VinceVol/High_Voltage_DC_Motor_Drive/Simulation/PMDC Motor.txt

* DC MOTOR MODEL SUBCURCUIT
* Pins: IN+ IN- SPEED POS
.SUBCKT DC_MOTOR 1 5 6 8
*V_AMP   1 0     AC 1  PWL(0MS 0V  1MS 10V  1000MS 10V  1010MS 0V  2000MS 0V)
*
* MOTOR VOLTAGE
RA	1	2	0.5
LA	2	3	0.0015
H_EMF	3 4	VSENSE2	0.05
VSENSE1	4	5	DC 0V
*
* MOTOR TORQUE BASED ON INERTIA AND FRICTION
H_TORQ	6 5	VSENSE1	0.05
LJ	6	7	0.00025
RB	7	8	0.0001
VSENSE2	8	0	DC	0V
*
* MOTOR POSITION
FPOS	5	11	VSENSE2	1
CPOS	11	5	1
RPOS	11	5	1MEG
.ENDS
