VinceVol/High_Voltage_DC_Motor_Drive/Readable_Schema/120VDC Treadmill Motor Controller/Order Sheet Amazon.csv

Reference | Qty | Value | Price | Exclude from BOM | Exclude from Board | Footprint | Datasheet
Cap Kit | 1 | https://www.amazon.com/Capacitor-Assortment-0-5pF-22uF-Electronics-Prototyping/dp/B0F38S1ZXJ |  |  |  | Capacitor_SMD:C_0603_1608Metric_Pad1.08x0.95mm_HandSolder | ~
Resistor Kit | 1 | https://www.amazon.com/Resistor-Assortment-Tolerance-Electronics-Prototyping/dp/B0F38XDMM5 |  |  |  | Resistor_SMD:R_0603_1608Metric_Pad0.98x0.95mm_HandSolder | ~
