VinceVol/High_Voltage_DC_Motor_Drive/Readable_Schema/Local_Components/ESMQ351VSN821MA45S/E-SNAP-IN_D35_L45__VSN_SLEEVE_STRUCTURE.stp

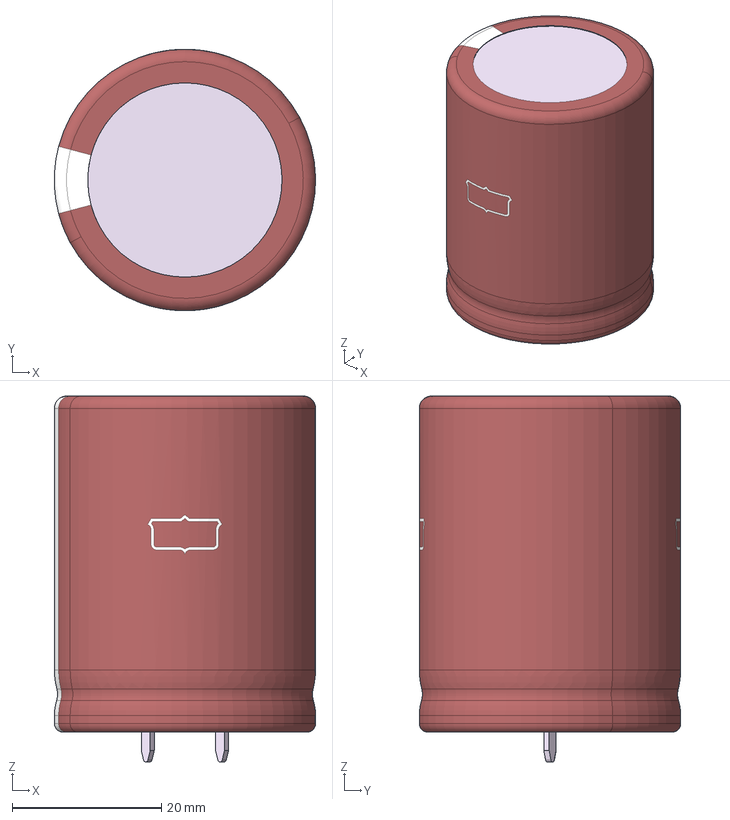
[picture p6: CAD file, 2026-10-08]
Readable_Schema/Local_Components/ESMQ351VSN821MA45S/E-SNAP-IN_D35_L45__VSN_SLEEVE_STRUCTURE.stp
35.0 x 35.0 x 49.0 mm
E-SNAP-IN_D35_L45_ELEMENT
E-SNAP-IN_VS_TERMINAL-
E-SNAP-IN_VS_TERMINAL+
