VinceVol/High_Voltage_DC_Motor_Drive/Readable_Schema/Local_Components/IRM-15-5/IRM-15-5--3DModel-STEP-56544.STEP

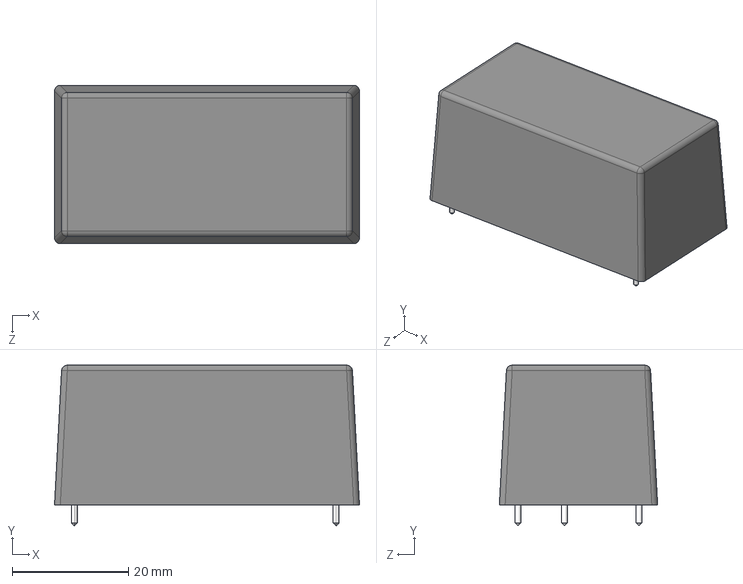
[picture p7: CAD file, 2026-10-08]
Readable_Schema/Local_Components/IRM-15-5/IRM-15-5--3DModel-STEP-56544.STEP
52.4 x 27.6 x 27.2 mm
