VinceVol/High_Voltage_DC_Motor_Drive/Readable_Schema/Local_Components/LGW2E102MELB40/CAP_B40_NCH.step

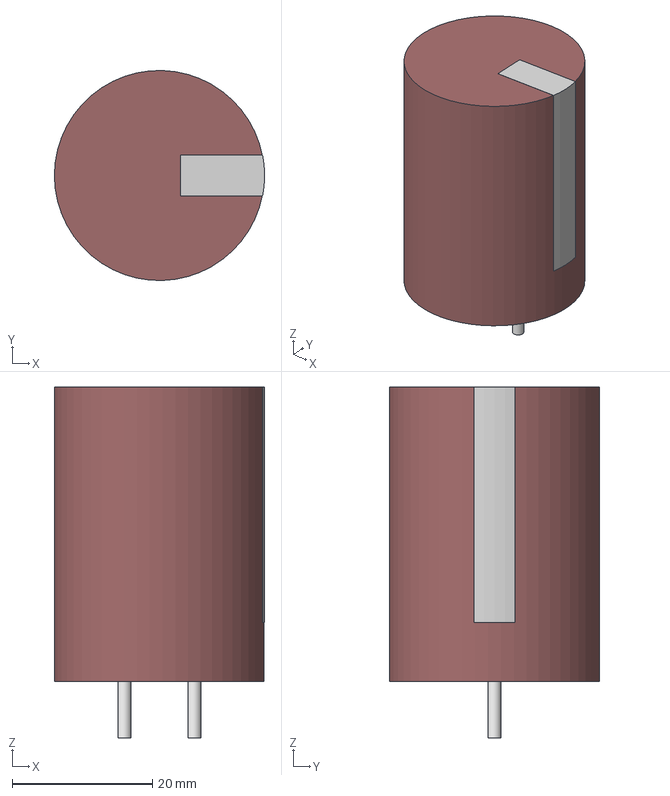
[picture p8: CAD file, 2026-10-08]
Readable_Schema/Local_Components/LGW2E102MELB40/CAP_B40_NCH.step
30.0 x 30.0 x 50.1 mm
