VinceVol/High_Voltage_DC_Motor_Drive/Readable_Schema/Local_Components/MSS1P4-M3_89A/MSS1P4-M3_89A.step

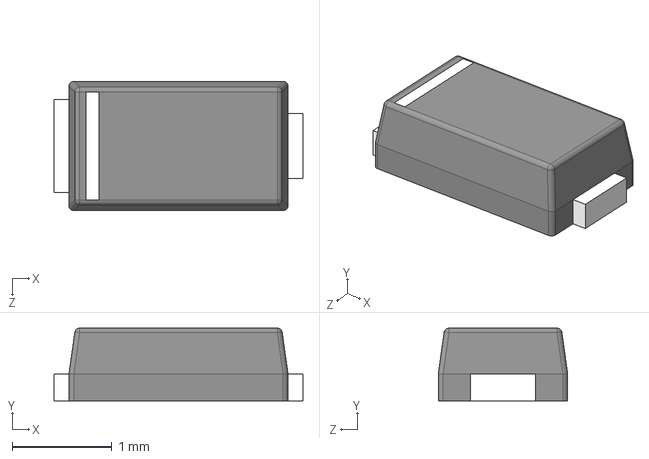
[picture p9: CAD file, 2026-10-08]
Readable_Schema/Local_Components/MSS1P4-M3_89A/MSS1P4-M3_89A.step
2.50 x 0.73 x 1.30 mm
