VinceVol/High_Voltage_DC_Motor_Drive/Readable_Schema/Local_Components/RCWCTE/RCWCTE.step

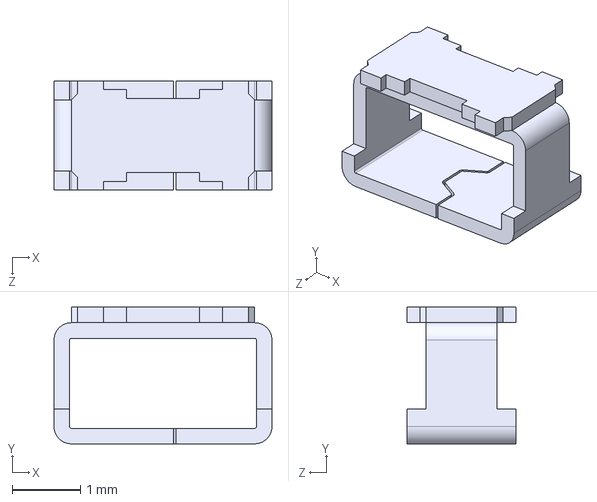
[picture p10: CAD file, 2026-02-23]
Readable_Schema/Local_Components/RCWCTE/RCWCTE.step
3.20 x 2.01 x 1.60 mm
