VinceVol/High_Voltage_DC_Motor_Drive/Readable_Schema/Local_Components/TB0011_350_03BE/TB0011-350-03BE.step

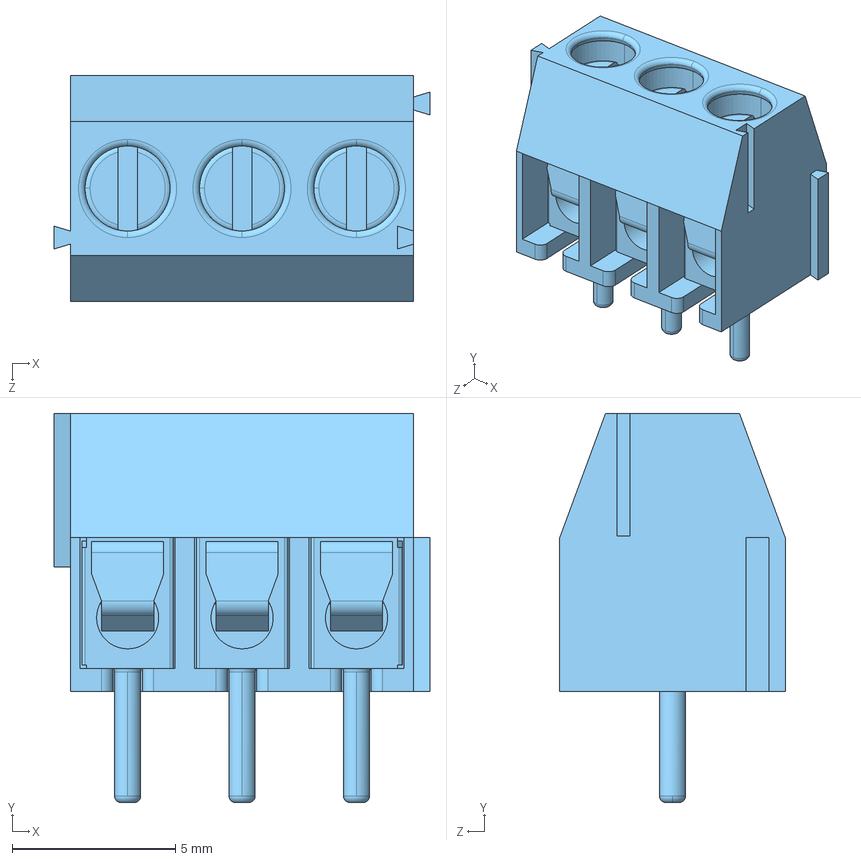
[picture p11: CAD file, 2026-02-23]
Readable_Schema/Local_Components/TB0011_350_03BE/TB0011-350-03BE.step
11.5 x 11.9 x 6.90 mm
