VinceVol/High_Voltage_DC_Motor_Drive/Readable_Schema/Local_Components/TB005_762_03BE/TB005 -762-03BE.step

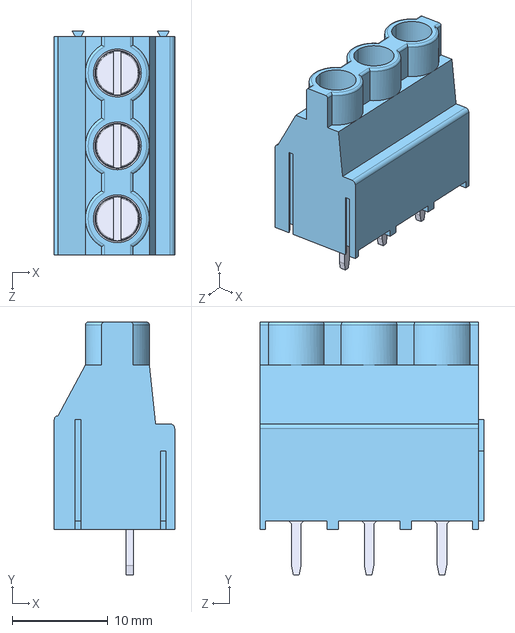
[picture p12: CAD file, 2026-02-19]
Readable_Schema/Local_Components/TB005_762_03BE/TB005 -762-03BE.step
12.6 x 26.5 x 23.5 mm
