VinceVol/High_Voltage_DC_Motor_Drive/Readable_Schema/Local_Components/TLV3201AIDBVR/TLV3201AIDBVR.step

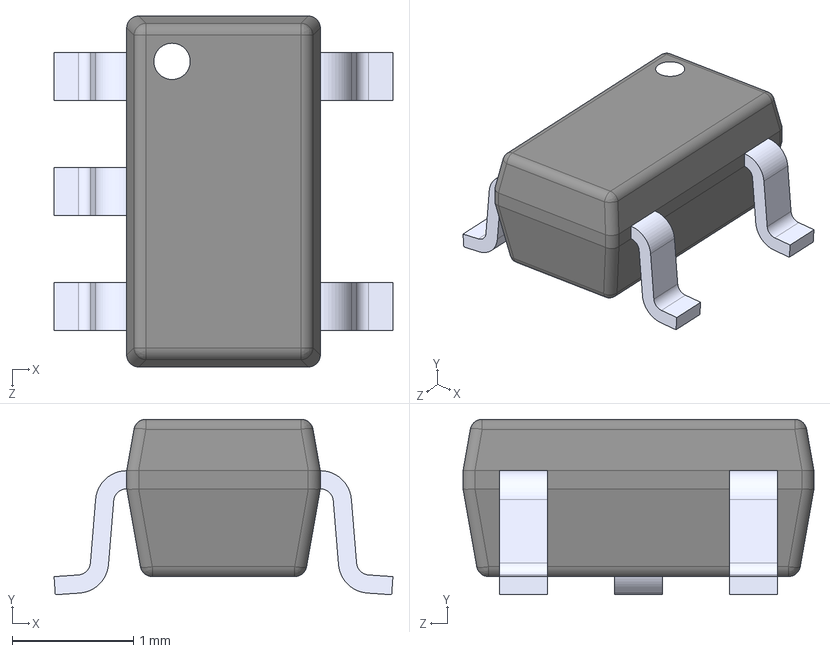
[picture p13: CAD file, 2026-10-08]
Readable_Schema/Local_Components/TLV3201AIDBVR/TLV3201AIDBVR.step
2.80 x 1.45 x 2.90 mm
