VinceVol/High_Voltage_DC_Motor_Drive/Cad/002_Test_Motor_Mount.FCStd

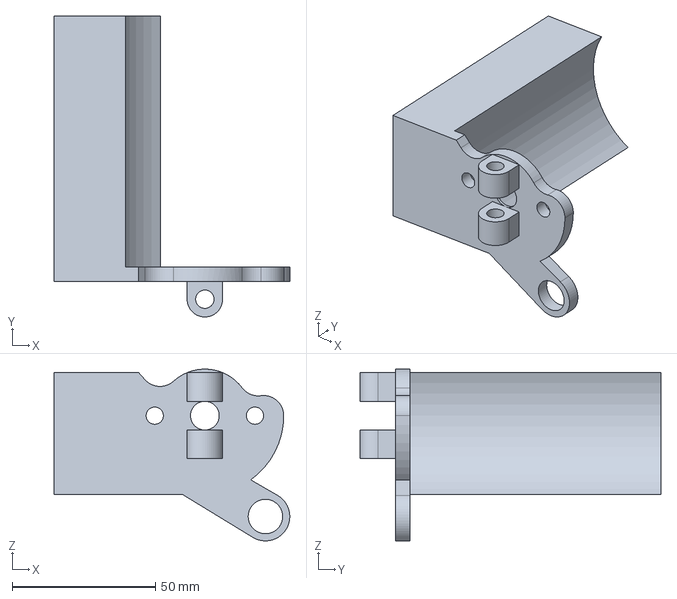
[picture p14: CAD file, 2026-11-10]
Cad/002_Test_Motor_Mount.FCStd
82.1 x 104.9 x 59.9 mm
