VinceVol/High_Voltage_DC_Motor_Drive/Cad/003_Magnet_MNT.FCStd

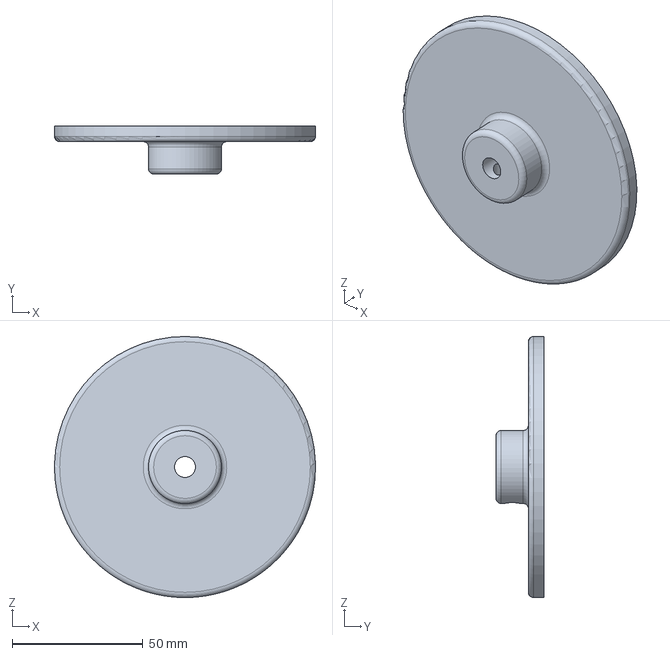
[picture p15: CAD file, 2026-11-09]
Cad/003_Magnet_MNT.FCStd
100.0 x 18.4 x 100.0 mm
