VinceVol/High_Voltage_DC_Motor_Drive/Cad/001_Test_Motor.FCStd

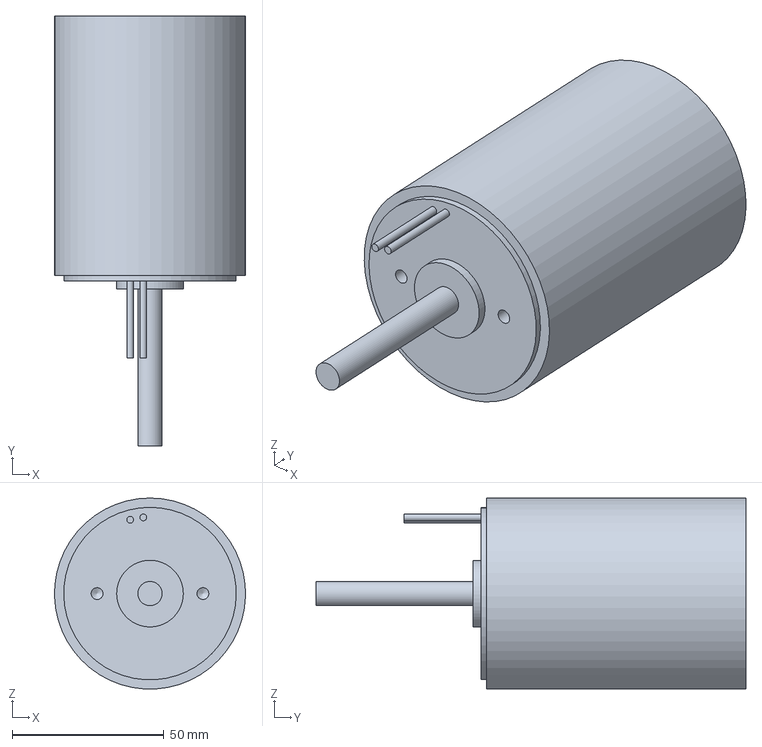
[picture p16: CAD file, 2026-11-09]
Cad/001_Test_Motor.FCStd
63.0 x 141.9 x 63.0 mm
