VinceVol/High_Voltage_DC_Motor_Drive/Cad/7674K93_DC Metallic-Object Proximity Switch016.FCStd

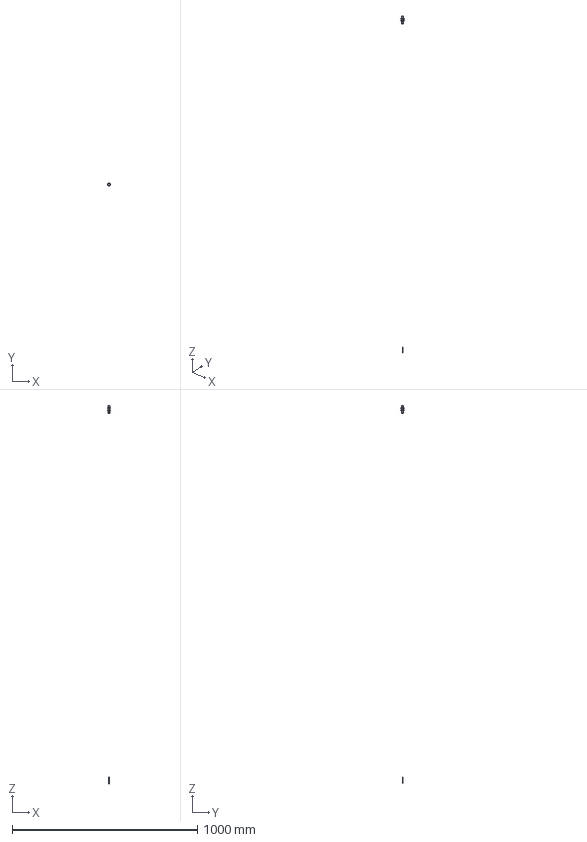
[picture p17: CAD file, 2026-11-09]
Cad/7674K93_DC Metallic-Object Proximity Switch016.FCStd
17.0 x 19.4 x 2043.2 mm
7674K93_DC Metallic-Object Proximity Switch
7674K93_DC Metallic-Object Proximity Switch001
7674K93_DC Metallic-Object Proximity Switch002
7674K93_DC Metallic-Object Proximity Switch003
7674K93_DC Metallic-Object Proximity Switch005
7674K93_DC Metallic-Object Proximity Switch006
7674K93_DC Metallic-Object Proximity Switch007
7674K93_DC Metallic-Object Proximity Switch008
7674K93_DC Metallic-Object Proximity Switch009
7674K93_DC Metallic-Object Proximity Switch010
7674K93_DC Metallic-Object Proximity Switch011
7674K93_DC Metallic-Object Proximity Switch012
7674K93_DC Metallic-Object Proximity Switch013
7674K93_DC Metallic-Object Proximity Switch014
7674K93_DC Metallic-Object Proximity Switch015
