VinceVol/High_Voltage_DC_Motor_Drive/(list of files, cad)

Other CAD files:
Cad/A001_Test_Motor_Assy.FCStd
