VinceVol/High_Voltage_DC_Motor_Drive/Simulation/Testing_Current_Sense.asc

A1: inv
A2: and
A3: srflop; Vhigh=1; Vlow=0
Gate_Driver: res; 10K
OC: voltage; PULSE(0 5 0 0 0 65ms 75ms)
PWM_MCU: voltage; PULSE(0 3.3 0 10ns 10ns 25us 50us)
Q1: pnp
Q2: npn
Q3: npn
R1: res; 1K
R2: res; 1K
R3: res; 10K
R5: res; 1Meg
R6: res; 1K
R7: res; 10K
R8: res; 10K
R9: res; 100K
V5: voltage; 5
Named nets: 0, S, R, O_SR
.tran 200m
DOMINANT SR Latch pull
pwm to ground when OC is high
reset reacts at 20KHZ
