VinceVol/High_Voltage_DC_Motor_Drive/Simulation/DC_SPEED_CONTROLLER_V3.asc

C1: cap; 0.1µ
C2: cap; 0.1µ
C3: cap; 0.1µ
C4: Cap; 4000µ
CPOS1: Cap; 1
D1: diode; VS-E5PH3006
D2: diode; VS-E5PH3006
D3: diode; VS-E5PH3006
D4: diode; VS-E5PH3006
D5: diode
FPOS1: f; VSENSE2; 1
H_EMF2: h; VSENSE2; 0.29
H_TORQ1: h; VSENSE1; 0.29
L1: ind; 0.01; Rser=0
LA2: ind; 0.5mH; Rser=0
Q1: npn; 2N2222
Q2: npn; 2N2222
Q3: npn; 2N2222
Q4: pnp; 2N4403
Q5: npn; 2N2222
Q6: pnp; 2N4403
R1: res; 10
R2: res; 1K
R3: res; 220
R4: res; 1.2Meg
R5: res; 10
R6: Res; 110
R7: res; 10
R8: res; 1K
R9: res; 10
R10: res; 330
R11: res; 250
R12: res; 110
R13: res; 220
R14: Res; 1K
R15: Res; 1K
R16: Res; 10K
R17: res; 5K
R18: res; 10K
R19: Res; 1K
R20: Res; 110
R21: res; 1K
R22: Res; 10K
R23: Res; 1K
R24: res; 9K
R25: res; 10K
R26: res; 8K
R27: res; 10
R28: res; 10
R29: res; 10K
RA2: Res; 0.6
RB1: Res; 0.002
RPOS1: Res; 1Meg
U1: irfb4227pbf
U2: FOD3182
U3: FOD3182
U4: FOD3182
U5: SRS0515
U6: irfb4227pbf
U7: irfb4227pbf
U8: LT1018
U9: FOD3182
U10: SRS0515
U11: SRS0515
U12: FOD3182
U13: irfb4227pbf
U14: irfb4227pbf
V1: voltage; SINE(0 170 60); Rser=0.1
V3: voltage; 3.3
V4: voltage; PULSE(0 3.3 0.08 10ns 10ns 25us 50us)
V5: voltage; PULSE(0 3.3 0 20us 20us 1 2)
V8: voltage; 5
VSENSE1: voltage; 0
VSENSE2: voltage; 0
Named nets: 0, Vtorq, Vangpos, Vs-HL, Vs-HR, Vdir, Vpwm, 5V_Vsupply, Vc-L, GND_Control, Vc-HL, Vc-HR, R-Brake
OptoIso Circuit
.tran 0 2000ms 0 5u
 
.model SW SW(Ron=10m Roff=100Meg Vt=0.5)
F - current controlled current source
I(VENSE2) - angular velocity modeled as current  (rad/sec)
Voltage across CPOS - angular position modeled as voltage (rad)
.include FOD3182.lib
.include irfb4227pbf.spi
Braking Resistor Circuit
.model SW_OFF SW(Vt=3)
