VinceVol/High_Voltage_DC_Motor_Drive/Simulation/BrakeResistor.asc

MOTOR: res; 0.5
R1: res; 2K
R2: res; 1.2Meg
R3: res; 20K
R4: res; 10K
U1: LT1018
V1: voltage; SINE(100 100 120)
V2: voltage; 3.3
Named nets: 0
.tran 100ms
