VinceVol/High_Voltage_DC_Motor_Drive/hv-moto-coto/firmware/src/autotune.rs

use core::ptr;

use bytemuck::{Pod, Zeroable};
use core_logic::lambda_tune::find_pi;
use defmt::info;
use embassy_rp::{
    flash::{Async, Flash},
    gpio::Input,
    peripherals::{FLASH, PIN_7},
    Peri,
};
use embassy_sync::{blocking_mutex::raw::CriticalSectionRawMutex, mutex::Mutex, watch::Receiver};
use embassy_time::{Duration, Instant, Timer};

use crate::{
    speed_sense::{double_tap, HallRpm},
    AUTOTUNE_OVERRIDE, CONFIG_START, FLASH_MUT_SIZE, FLOOR_TBL_CNT, MOT_LOOP_EN, PI_TBL_CNT,
    PWM_WATCH, RPM_FILT_WATCH, RPM_RAW_WATCH,
};

//as described in lib.rs, basically this is here to generate a lookup table and optimize the pid parameters
#[repr(C)]
#[derive(Clone, Copy, Pod, Zeroable)]
pub struct PidConfig {
    pub floor_table_rpm: [u16; FLOOR_TBL_CNT],
    pub floor_table_pwm: [u16; FLOOR_TBL_CNT],
    pub pi_table_rpm: [f32; PI_TBL_CNT], //rpm setpoint
    pub pi_table_p: [f32; PI_TBL_CNT],   //p components of PID
    pub pi_table_i: [f32; PI_TBL_CNT],   //i components of PID
    flash_check: [u8; 8],
}

impl Default for PidConfig {
    fn default() -> Self {
        Self {
            floor_table_rpm: [0; FLOOR_TBL_CNT],
            floor_table_pwm: [0; FLOOR_TBL_CNT],
            pi_table_rpm: [0.0; PI_TBL_CNT],
            pi_table_p: [0.35; PI_TBL_CNT],
            pi_table_i: [0.2; PI_TBL_CNT],
            flash_check: FLASH_CHECK,
        }
    }
}

const SECTOR_SIZE: u32 = 4 * 1024; //Size allocated for this struct
const STORAGE_OFFSET: u32 = 0; //offset from the CONFIG_START
const FLASH_CHECK: [u8; 8] = *b"PidConfi";

impl PidConfig {
    pub async fn run_thy_tune<'a>(
        flash_mut: &Mutex<
            CriticalSectionRawMutex,
            Flash<'static, FLASH, Async, { FLASH_MUT_SIZE }>,
        >,
        rpm_raw_watch: &mut Receiver<'a, CriticalSectionRawMutex, u16, 100>,
    ) -> Self {
        //Tell the motor req signals to ignore mesa inputs
        let tune_sender = AUTOTUNE_OVERRIDE.sender();
        tune_sender.send(true);

        //Start with the current parameters TODO manage to unwrap TODO
        let mut the_tune = PidConfig::load(flash_mut).await.unwrap();

        //Generate the lookup tables by slowly incrementing pwm
        the_tune.gen_floor_tbl(rpm_raw_watch).await;

        //Generate PID lookup tbl
        the_tune.gen_pid_tbl(rpm_raw_watch).await;

        //Save the tune TODO manage the unwrap TODO
        the_tune.save(flash_mut).await.unwrap();
        tune_sender.send(false);
        the_tune
    }

    async fn gen_floor_tbl<'a>(
        &mut self,
        rpm_filt_watch: &mut Receiver<'a, CriticalSectionRawMutex, u16, 100>,
    ) {
        //disable pid controlled motor loop
        MOT_LOOP_EN.signal(false);
        Timer::after_secs(1).await; // give the motor loop time to fully shut down

        //rip through divisions of FLOOR_TBL_CNT pwm signals
        for (i, pwm) in (0..FLOOR_TBL_CNT)
            .map(|i| (1000 as f64 * i as f64 / (FLOOR_TBL_CNT as f64 - 1.0)) as u16)
            .enumerate()
        {
            PWM_WATCH.sender().send(pwm);
            Timer::after(Duration::from_millis(50)).await; //short pause to allow controller to react

            self.floor_table_rpm[i] = double_tap(rpm_filt_watch).await;
            self.floor_table_pwm[i] = pwm;
        }
        MOT_LOOP_EN.signal(true);
    }

    async fn gen_pid_tbl<'a>(
        &mut self,
        rpm_raw_watch: &mut Receiver<'a, CriticalSectionRawMutex, u16, 100>,
    ) {
        //disable pid controlled motor loop
        MOT_LOOP_EN.signal(false);
        Timer::after_secs(1).await; // give the motor loop time to fully shut down

        //Save the times, pwms and rpms into arrays to feed to a core logic fn that
        // will calculate the P & I terms
        let mut times: [u64; 2] = [0, 0]; //times surrounding the 0.6321K time constant
        let mut rpms: [u64; 2] = [0, 0]; //rpms surrounding that same item -- interpolation needed
        let mut pwm_range: [u16; 2] = [0, 0]; //the setpoint start finish
        let mut rpm_range: [u64; 2] = [0, 0]; //resulting steady state rpms

        //start pwm at zero and give the motor sufficient time to settle down
        PWM_WATCH.sender().send(0);
        Timer::after_secs(3).await;

        //rip through divisions of PI_TBL_CNT pwm signals
        for (i, pwm) in (0..PI_TBL_CNT)
            .map(|i| (1000 as f64 * i as f64 / (PI_TBL_CNT as f64 - 1.0)) as u16)
            .enumerate()
        {
            //Set the pwm range
            pwm_range.rotate_left(1);
            pwm_range[1] = pwm;

            //move over rpm to make room for the finish (the last one's finish is the new ones start)
            rpm_range.rotate_left(1);

            //find the other end of the rpm range
            PWM_WATCH.sender().send(pwm_range[1]);
            rpm_range[1] = double_tap(rpm_raw_watch).await as u64;

            //Go back to the starting line
            PWM_WATCH.sender().send(pwm_range[0]);

            //Set the rpm goal
            let rpm_goal = (6321 * (rpm_range[1] - rpm_range[0])) / 10000 + rpm_range[0];

            //Tell mcu to pwm to the finish line and start the timer
            let timer = Instant::now();
            PWM_WATCH.sender().send(pwm);
            loop {
                rpms.rotate_left(1); //move old rpm to first slot
                times.rotate_left(1); //move old time to first slot

                //Once rpm updates update the right slot with the new values
                rpms[1] = rpm_raw_watch.changed().await as u64;
                times[1] = timer.elapsed().as_micros();

                info!("new rpms {}", rpms);
                info!("new times {}", times);
                //Once in the right rpm range surrounding 1 time const
                if rpms[0] <= rpm_goal && rpms[1] >= rpm_goal {
                    // calculate k = dRPM/dPWM
                    let k = (rpm_range[1] - rpm_range[0]) as f32
                        / ((pwm_range[1] - pwm_range[0]) as f32);

                    //determine P and I components
                    let (kp, ki) = find_pi(1.0, k, times, rpms, rpm_goal);

                    //Terminal info ------------------
                    info!(
                        "rpm_range: {:?}\npwm_range: {:?}\nk = {}\nrpms = {:?}\ntimes = {:?}",
                        rpm_range, pwm_range, k, rpms, times
                    );
                    info!(
                        "For {} -> {}:\nkp = {} \nki = {}",
                        rpm_range[0], rpm_range[1], kp, ki
                    );
                    //Terminal info ------------------

                    //save the info into self
                    self.pi_table_rpm[i] = rpm_range[1] as f32;
                    self.pi_table_p[i] = kp;
                    self.pi_table_i[i] = ki;

                    //reset the rpms and times for the next rpm range
                    rpms = [0; 2];
                    times = [0; 2];
                    break;
                }
            }
        }
        MOT_LOOP_EN.signal(true);
    }

    //Load up the config perameters from flash
    pub async fn load(
        flash_mut: &Mutex<
            CriticalSectionRawMutex,
            Flash<'static, FLASH, Async, { FLASH_MUT_SIZE }>,
        >,
    ) -> Result<Self, embassy_rp::flash::Error> {
        let mut flash = flash_mut.lock().await;
        let storage_location = (ptr::addr_of!(CONFIG_START) as u32) - 0x10000000 + STORAGE_OFFSET;

        // Allocate a temporary byte buffer matching the size of our struct
        let mut buffer = [0u8; core::mem::size_of::<PidConfig>()];

        // Read directly from flash into our byte buffer
        flash.read(storage_location, &mut buffer).await?;

        //Check if the sector is completely uninitialized (erased flash is all 0xFF)
        if buffer.iter().all(|&b| b == 0xFF) {
            return Ok(PidConfig::default()); // or your initial default values
        }

        //Safe to cast via bytemuck now that we know it's not empty
        let pid_config = *bytemuck::from_bytes::<PidConfig>(&buffer);
        if pid_config.flash_check != FLASH_CHECK {
            return Ok(PidConfig::default());
        }

        //if it wasn't all zeros and the flash check is valid then open the config
        return Ok(pid_config);
    }
    async fn save(
        &self,
        flash_mut: &Mutex<
            CriticalSectionRawMutex,
            Flash<'static, FLASH, Async, { FLASH_MUT_SIZE }>,
        >,
    ) -> Result<(), embassy_rp::flash::Error> {
        let mut flash = flash_mut.lock().await;
        let storage_location = (ptr::addr_of!(CONFIG_START) as u32) - 0x10000000 + STORAGE_OFFSET;

        // Convert struct reference to a &[u8] safely using bytemuck
        let bytes = bytemuck::bytes_of(self);

        // 1. Flash memory must be erased before writing.
        // Erase a full 2KB sector containing our STORAGE_OFFSET.
        flash.blocking_erase(storage_location, storage_location + SECTOR_SIZE)?;

        // 2. Write the bytes to the flash offset
        flash.blocking_write(storage_location, bytes)?;

        Ok(())
    }
}

//task reacting to whether the button for enabling autotune is depressed or not
//use debounce to avoid noise on trigger
const DEBOUNCE_THRESHOLD_US: u64 = 2000;
#[embassy_executor::task]
pub async fn atune_btn_run(
    autotune_button_p: Peri<'static, PIN_7>,
    flash_mut: &'static Mutex<
        CriticalSectionRawMutex,
        Flash<'static, FLASH, Async, { FLASH_MUT_SIZE }>,
    >,
) {
    let mut atune_btn = Input::new(autotune_button_p, embassy_rp::gpio::Pull::Down);
    let mut rpm_raw_watch = RPM_RAW_WATCH.receiver().unwrap(); //Direct feed from the hall sensor

    //watch for a button press and then fire off the autotune fn
    loop {
        atune_btn.wait_for_rising_edge().await;
        Timer::after_micros(DEBOUNCE_THRESHOLD_US).await;
        PidConfig::run_thy_tune(flash_mut, &mut rpm_raw_watch).await;
    }
}
