VinceVol/High_Voltage_DC_Motor_Drive/(commit log)

2026-01-21 First commit with files, the dc motor representation seems to be accurate and the h bridge is working. Need to start looking at simplifying the lower half of the bridge so that we dont need seperate 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
2026-01-21 Worked on updating components to what my dad ordered. Spent most of my time realizing the full bridge gate driver that was ordered is definitely not going to interface with a microcontroller. Only re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
2026-01-22 updated fets to be the ones we bought, still need to add current senesing etc etc
2026-01-23 starting working on the AC rectifying circuit with the dc to dc converters. Right now its a non working bridge rectifier with an ac source. Mainly doing research on the side to understand how to size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
2026-01-25 Got a working copy of the optoisolated gate driver FOD3182 working, asked ai to use the HCPL3120 txt file to generate something with the limits seen on the FOD3182. Everything seems to be working ok.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
2026-01-25 Updated gate drivers properly as well as started adding the proper dc to dc inverters
2026-01-25 Got the 120vac rectified input going properly as well as the seperate dc to dc 15v converters. will work on shunt resistor with current sensing and isolated grounds next
2026-01-26 tried implementing a pnp on top and npn on bottom totem poll to get rid of current losses when pulling one dir to ground, turns out that is tricky due to the pnp needing to see a higher voltage at th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
2026-01-27 Having issues with current sensing module also need to up the transistor sizing since were seeing close to 90 amps peak going through the fets
2026-01-27 got the current sensing working, didnt realize the sensor acts like a shunt resistor and needs to be in series with the vdc, not sure why it took me so long to figure that out. Used a low pass filter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
2026-01-29 still having issues solving the inrush current at each pwm 3.3v, Ive tried a few things to mitigate this like schottky diodes, higher gate resistance and higher pwm frequency -which is only meant for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
2026-01-29 Im still stuck on the massive current spikes although discovering that they r showing up between when the 3.3v pwm is high and when the motor driver switches on
2026-01-30 finally fixed the massive current draw spikes by changing the mosfet chosen. still not really sure what in the mosfet model was causing this but who cares
2026-01-30 Started working on the kicad schematics, nothing on digikey is working so will try to add footprints and whatnot at work
    [120VDC Treadmill Motor Controller.kicad_pcb, 120VDC Treadmill Motor Controller.kicad_sch, FET Circuit.kicad_sch, Feeback.kicad_sch, HBridge.kicad_sch, PiPico.kicad_sch, Power.kicad_sch]
2026-02-02 I cant for the life of me get the current sensing to actually properly scale with current, I treid 5 different sim models and right now the DA is the best but doesnt start showing anything till aroun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
    [FET Circuit.kicad_sch, HBridge.kicad_sch, PiPico.kicad_sch, Power.kicad_sch]
2026-02-02 theres something wrong with my circuit, where basically its reading out the current draw as if I had a 5 ohm resistor in place for the motor instead of the 0.5 ohm resistor. Essentially ltspice is te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
2026-02-03 realizing theres always been an issue with my h bridge current draw but regardless working on getting the current testing circuit working. Seems like proper power to the VOC pin just bugs out my sim 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
2026-02-03 finally made some progress with current sense circuit, basically the OC pin needs to have a pull up resistor not pull down. Im trying to test within that circuit using that OC to trigger a pnp that t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
2026-02-04 add v3. cleaned up vincent mess, added resistor for startup as just a test of concept
2026-02-04 changed a few things in the current sensing ciruit, didnt really have a voltage devider set up to actually be able to pull the pwm to gnd
2026-02-04 Ok so we shouldnt use the OC pin to directly drive the pwm because itll turn on and off way too fast and blow everything up. Instead we need to creat a sr latch to turn off when the oc is high and tu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
2026-02-04 made some progress setting up a SR latch, had some issues getting a NPN to actually pull to ground on the OC representation. Right now I think I just have resistor sizing issues to get the pwm to act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
2026-02-04 got things kind of working. I think the issue is the S switch remains high the whole time so then when the pwm goes back to H the pull to gnd npn turns back off since theyre both H. I think I need to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
2026-02-09 got the oc to pull pwm to ground by using a dominant sr latch rather than just a sr latch. essentially now no matter what the oc pin will toverpower the r pin
2026-02-09 started working on a brake resistor circuit. Stuck on getting the comparator to actually compare, not 1000% sure what Im doing
2026-02-11 Changed the comparator to get the circuit working and added it to the v3 doc. need to test if it works when motor shuts off
2026-02-12 just started testing the brake resistor, something is off as the resistor is drawing current even though the mosfet should be off. Need to spend some more time looking at it.
2026-02-12 Tried better simulating back emf with little success, started adding footprints and real components to the readable schema (kicad)
    [120VDC Treadmill Motor Controller.kicad_sch, FET Circuit.kicad_sch, Feeback.kicad_sch, HBridge.kicad_sch, PiPico.kicad_sch, Power.kicad_sch]
2026-02-13 Updated some more footprints and started learning about base resistor sizing and the importance of Pavg rather than Ppeak. changed low side fets in kicad to use a shared power supply
    [120VDC Treadmill Motor Controller.kicad_sch, Feeback.kicad_sch, HBridge.kicad_sch, LS FET.kicad_sch, PiPico.kicad_sch, Power.kicad_sch]
2026-02-17 removed a pullup resistor from a pnp in the ltspice model on current sense and started drawing the current sense model in kicad. We still have ways to go
    [Feeback.kicad_sch]
2026-02-18 Continuing to update footprints, did some follow up math on low pass filter for adc voltage coming out of current sense system
    [120VDC Treadmill Motor Controller.kicad_pcb, FET Circuit.kicad_sch, Feeback.kicad_sch, HBridge.kicad_sch, LS FET.kicad_sch, PiPico.kicad_sch, Power.kicad_sch]
2026-02-18 continued to add footprints, we still need to add hall effect circuit and possible brake resistor subcircuit. We may also want to consider switching the large 15v isolated power supplies to be smd as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
    [120VDC Treadmill Motor Controller.kicad_pcb, 120VDC Treadmill Motor Controller.kicad_sch, FET Circuit.kicad_sch, Feeback.kicad_sch, HBridge.kicad_sch, LS FET.kicad_sch, PiPico.kicad_sch, Power.kicad_sch]
2026-02-18 -There are no power supply/ gate driver variants for the ones chosen that support smd -We NEED to workout how we want to communicate with both linuxCNC for the CNC controller and a potentiometer for 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
    [120VDC Treadmill Motor Controller.kicad_pcb, 120VDC Treadmill Motor Controller.kicad_sch, FET Circuit.kicad_sch, HBridge.kicad_sch, PiPico.kicad_sch]
2026-02-19 Still need to do the majority of the things mentioned in the last commit, made some progress on the mcu pinout headers, fixed a few resistors that were putting npns in a high side drive state (preven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
    [120VDC Treadmill Motor Controller.kicad_sch, FET Circuit.kicad_sch, Feeback.kicad_sch, HBridge.kicad_sch, LS FET.kicad_sch, PiPico.kicad_sch, Power.kicad_sch]
2026-02-19 started working on the e_stop circuit. Basically just using a relay to shut off all power to the system, including both the mcu and the 170 DC 120HZ.
    -Need to finish the E_stop subcircuit
    -Still need to start wrapping up the brake resistor subcircuit
    -input capacitor sizing
    [120VDC Treadmill Motor Controller.kicad_pcb, 120VDC Treadmill Motor Controller.kicad_sch, FET Circuit.kicad_sch, Feeback.kicad_sch, HBridge.kicad_sch, LS FET.kicad_sch, PiPico.kicad_sch, Power.kicad_sch]
2026-02-19 Finished adding e stop circuit and roughly choosing a cap for high voltage line -- mostly to deal with ripple current. Almost done implementing the brake resistor subcircuit
    [120VDC Treadmill Motor Controller.kicad_pcb, 120VDC Treadmill Motor Controller.kicad_sch, Brake_Resistor.kicad_sch, Power.kicad_sch, TB005 -762-03BE.step]
2026-02-20 realizing we want shared footprints for all resistors
    -Double check to make sure all sub 1W resistors share a footprint
    -Choose and size a actual brake resistor, we currently own 3x 4ohm 100w resistors, not sure if those would be sufficient
    [Brake_Resistor.kicad_sch]
2026-02-23 we have reached the point of starting to roughly place where components should go (have not started messing with traces). -Confirm heatsink size so that we can block that area out on the schema -add 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
    [120VDC Treadmill Motor Controller.kicad_pcb, 120VDC Treadmill Motor Controller.kicad_sch, Brake_Resistor.kicad_sch, Feeback.kicad_sch, HBridge.kicad_sch, PiPico.kicad_sch, Power.kicad_sch, TB0011-350-03BE.step]
2026-02-23 Weve opted to locate the heat sink outside the board so I dont need to size it now. Ive started adding a few traces and I think the layout is fairly ok for now. I tried my best to split high and low 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
    [120VDC Treadmill Motor Controller.kicad_pcb, Feeback.kicad_sch, HBridge.kicad_sch]
2026-02-23 Stretched out the pcb a bit to give me some more room to work with. -Missing something to prevent main cap from blowing up on startup
    [120VDC Treadmill Motor Controller.kicad_pcb, Brake_Resistor.kicad_sch, Feeback.kicad_sch, HBridge.kicad_sch, RCWCTE.step]
2026-02-24 still working to figure out what all the supporting components are for this digital gate driver.
    REASONS FOR TRYING TO SWITCH:
    -Longer lasting (current opto isolator led wears out)
    -Get rid of bjts and delays surrounding using those
    -Even though we had mitigated turning on and off the high and low side to short at the same time, we didnt do so in a way that works with noise, this new gate driver allows for a supposedly much better handle on noise and isolates the high and low side for us
    -Additionally consistency of this digital gate driver should be higher given that you are not relying on bjt resistor sizing to drive delays
    [120VDC Treadmill Motor Controller.kicad_pcb, 120VDC Treadmill Motor Controller.kicad_sch, Brake_Resistor.kicad_sch, FET Circuit.kicad_sch, Feeback.kicad_sch, HBridge.kicad_sch, PiPico.kicad_sch, Power.kicad_sch]
2026-02-24 Working through this new gate driver still. Need to size the various input resistors and capacitors
    [HBridge.kicad_sch]
2026-02-24 Finished choosing real components for the digitally isolated drives. Mainly followed TIs 100khz example and chose to use mostly repeat components. Now confirming the design doesnt suck then working o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
    [120VDC Treadmill Motor Controller.kicad_pcb, 120VDC Treadmill Motor Controller.kicad_sch, Brake_Resistor.kicad_sch, Feeback.kicad_sch, HBridge.kicad_sch, PiPico.kicad_sch, Power.kicad_sch]
2026-02-24 Changed ground naming and redid a bit of the pinouts between the pico and the h bridge -- need to fix the feedback loop to use a or gate for pwm_a and pwm_b to combine to one big reset
    [120VDC Treadmill Motor Controller.kicad_sch, Brake_Resistor.kicad_sch, Feeback.kicad_sch, HBridge.kicad_sch, PiPico.kicad_sch, Power.kicad_sch]
2026-02-25 Need to fix digital isolation branch as I messed up and pushed to main
    [120VDC Treadmill Motor Controller.kicad_sch, Brake_Resistor.kicad_sch, Feeback.kicad_sch, HBridge.kicad_sch, PiPico.kicad_sch, Power.kicad_sch]
2026-02-25 Reworking the whole comparator for brake resistor logic circuit as all my HV and LV grounds are messed up and I think the comparator I was using was wrong
    [Brake_Resistor.kicad_sch, TLV3201AIDBVR.step]
2026-02-25 -Tried to fix a decent portion of the feedback circuit. Basically the new gate drivers have a enable pin so it makes more sense to tie the OC pin directly to the function of EN. Also kept the SR latc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
    [120VDC Treadmill Motor Controller.kicad_sch, Brake_Resistor.kicad_sch, Feeback.kicad_sch, HBridge.kicad_sch, PiPico.kicad_sch, Power.kicad_sch]
2026-02-26 Did a schema review and decided that many large caps are going to be needed to support the pwm induced back emf. without the large caps the difference between the supplied voltage and back emf will b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
    [120VDC Treadmill Motor Controller.kicad_sch, Brake_Resistor.kicad_sch, Feeback.kicad_sch, HBridge.kicad_sch, PiPico.kicad_sch, Power.kicad_sch]
2026-02-26 -Removed brake resistor subcircuit -Worked up bus cap to 4x 820uF 400V caps -changed the fets to 600V 49A 60mOhm RdsON --------------------------------------------- -need different isolated power sup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
    [120VDC Treadmill Motor Controller.kicad_pcb, 120VDC Treadmill Motor Controller.kicad_sch, CAP_B40_NCH.step, E-SNAP-IN_D35_L45__VSN_SLEEVE_STRUCTURE.stp, Feeback.kicad_sch, HBridge.kicad_sch, PiPico.kicad_sch, Power.kicad_sch]
2026-02-27 -changed the feedback loop to use a and gate rather than a SR latch, were also back to not needing any input from the mcu for the whole OC protection --missing a footprint for the and gate chip -Stil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
    [120VDC Treadmill Motor Controller.kicad_sch, Feeback.kicad_sch, HBridge.kicad_sch, PiPico.kicad_sch, Power.kicad_sch]
2026-02-27 fixed a few accidental line connects
    [120VDC Treadmill Motor Controller.kicad_sch, Feeback.kicad_sch, HBridge.kicad_sch, PiPico.kicad_sch, Power.kicad_sch]
2026-02-28 -Worked on getting the precharge circuit working --Picked a gate driver --Picked Ron and Roff resistors
    -Still need to work through the board logic for turning off the gate when the caps reach 170vdc
    [120VDC Treadmill Motor Controller.kicad_sch, Feeback.kicad_sch, HBridge.kicad_sch, PiPico.kicad_sch, Power.kicad_sch]
2026-03-01 -Changed the precharge circuit gate driver to the TP5I3 --This gate driver provides its own 10v isolated PS, which saves a lot of room
    -changed the schottky for the pi pico to a smd equivalent.
    [120VDC Treadmill Motor Controller.kicad_sch, PiPico.kicad_sch, Power.kicad_sch]
2026-03-02 -Added some caps directly next to the isolated power supplies -Resized some gate resistors to be 1206 -chose a precharge circuit resistor HSA50330RJ -pulled caps low so they drain to a relatively saf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
    [HBridge.kicad_sch, Power.kicad_sch]
2026-03-02 -Checked all the footprints to see whether there was some kind of mixup. Being told the Fets have the D and S reversed but not seeing this when comparing to datasheet
    -Still need to swap bridge recitifier for a vertically mounted one
    -Closing in on drawing the actual PCB
    [120VDC Treadmill Motor Controller.kicad_sch, Feeback.kicad_sch, HBridge.kicad_sch, PiPico.kicad_sch, Power.kicad_sch]
2026-03-02 -Updated kicad fet symbol to swap gate and drain numbers to match the datasheet
    -There are not vertically mounted rectifier alternatives that are capable of 50 amps so stuck with the current one
    [HBridge.kicad_sch, Power.kicad_sch]
2026-03-03 -Started adding a voltage sense circuit --Need to size caps and resistors --Need to share pot and linux cnc adc pins so we dont need to add a seperate adc spi multiplexer
    -Need to start redoing a safer cap discharge circuit
    [120VDC Treadmill Motor Controller.kicad_sch, Feeback.kicad_sch, HBridge.kicad_sch, PiPico.kicad_sch, Power.kicad_sch]
2026-03-03 -Added voltage sense
    -Need to add some kind of LED to tell that the board is HOT
    -Need to work with ross to understand the DNMOS setup
    [120VDC Treadmill Motor Controller.kicad_sch, Feeback.kicad_sch, HBridge.kicad_sch, PiPico.kicad_sch, Power.kicad_sch]
2026-03-04 -Feedback Schema --fixed some of fine details surrounding pulling some stuff to ground --missing bypass caps --resizing footprints
    -H bridge
    --Chose higher current rating schottky diode
    --Resized footprints and chose better
    [120VDC Treadmill Motor Controller.kicad_sch, Feeback.kicad_sch, HBridge.kicad_sch, MSS1P4-M3_89A.step, PiPico.kicad_sch, Power.kicad_sch]
2026-03-04 -Basically realized that we need to redo the whole power structure
    [PiPico.kicad_sch, Power.kicad_sch]
2026-03-04 -Changed to a 15w 5v power supply instead of a 5w. (Achieved nothing else wtf)
    [Feeback.kicad_sch, HBridge.kicad_sch, IRM-15-5--3DModel-STEP-56544.STEP, IRM-15-5.step, PiPico.kicad_sch, Power.kicad_sch]
2026-03-04 -Added a more comprehensive discharge circuit --branch 1 uses a DNMOS with neg iso supply to do nothing when circuit is plugged in and to pull caps through 3.3K when circuit is off --Branch 2 passive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
    [120VDC Treadmill Motor Controller.kicad_sch, Cap_Discharge.kicad_sch, Feeback.kicad_sch, HBridge.kicad_sch, PiPico.kicad_sch, Power.kicad_sch]
2026-03-06 -Think we're finished with the schematic (finally) --Upped the LED resistors and added a few more supporting caps for the 3.3v iso supply in the feedback schema
    -Started placing footprints
    --Now that we're using how air instead of oven I'm not going to try and keep all SMD components on the same side anymore
    [120VDC Treadmill Motor Controller.kicad_pcb, 120VDC Treadmill Motor Controller.kicad_sch, Cap_Discharge.kicad_sch, Feeback.kicad_sch, HBridge.kicad_sch, PiPico.kicad_sch, Power.kicad_sch]
2026-03-06 -placed more components surrounding the H bridge, thinking may have placed things a little too close to each. I think it may be time to figure out vias so that I can use both sides of the board lol. 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
    [120VDC Treadmill Motor Controller.kicad_pcb]
2026-03-07 -Getting fairly stuck on the best way to layout some of these high voltage components, especially the high current line that requires a pour rather than a trace
    [120VDC Treadmill Motor Controller.kicad_pcb, HBridge.kicad_sch]
2026-03-07 -Rotated a few components --Playing with different layout ideas, no major changes
    [120VDC Treadmill Motor Controller.kicad_pcb, Feeback.kicad_sch, HBridge.kicad_sch, Power.kicad_sch]
2026-03-09 -Finally figured out how to use a board fill. Despite having changed number of board layers at home and adding the netclasses, those board settings aren't showing up here --If board settings arent gl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
    -Repositioning components to try and get them to share similar pours
    -Still need to figure out how to set things up to be able to add solder to the High current lines
    [120VDC Treadmill Motor Controller.kicad_pcb, 120VDC Treadmill Motor Controller.kicad_sch, Cap_Discharge.kicad_sch, Feeback.kicad_sch, HBridge.kicad_sch, PiPico.kicad_sch, Power.kicad_sch]
2026-03-10 -Playing around with different layouts --With the additional two layers the GND and 5V planes can be shared amongst all LV components, making things a bit easier and pushing me to really start laying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
    [120VDC Treadmill Motor Controller.kicad_pcb, HBridge.kicad_sch, Power.kicad_sch]
2026-03-12 Almost finished placing all of the components, looking a bit closer at some of the HV stuff
    [120VDC Treadmill Motor Controller.kicad_pcb]
2026-03-16 Finished placing all components without any traces, looking to confirm with legit engineers whether this is in the ballpark before starting to draw a bunch of traces
    [120VDC Treadmill Motor Controller.kicad_pcb]
2026-03-17 -Changed all footprints from metric to imperial sizing --This meant repositioning everything on the board again.
    -Did the first pour for HV GND
    [120VDC Treadmill Motor Controller.kicad_pcb, Cap_Discharge.kicad_sch, Feeback.kicad_sch, HBridge.kicad_sch, PiPico.kicad_sch, Power.kicad_sch]
2026-03-18 -learned ctrl T to place array of vias and that you kind of want to place an array of vias directly on the smd pads in order to get to underlying GND and PWR planes.
    -Started wrapping up the HV GND plane and vias. Ran into some issues where I can't unhighlight certain nets lol
    [120VDC Treadmill Motor Controller.kicad_pcb]
2026-03-18 Added a few more fill zones for high power stuff
    [120VDC Treadmill Motor Controller.kicad_pcb, HBridge.kicad_sch, Power.kicad_sch]
2026-03-19 Continuing fill zones and vias for days, likely a few more hours to wrap up the high voltage side
    [120VDC Treadmill Motor Controller.kicad_pcb]
2026-03-19 Almost done connecting all the traces on the H bridge side, Sounding like Pete is going to bash on this pretty hard so will likely need to redo all this. Good practice regardless
    [120VDC Treadmill Motor Controller.kicad_pcb, HBridge.kicad_sch]
2026-03-22 worked through a few more low voltage components
    finally fixed netclass naming transfer issues by adding to my gitignore
    [120VDC Treadmill Motor Controller.kicad_pcb, 120VDC Treadmill Motor Controller.kicad_sch, Cap_Discharge.kicad_sch, Feeback.kicad_sch, HBridge.kicad_sch, PiPico.kicad_sch, Power.kicad_sch]
2026-03-23 -Still working on traces, working through mostly traces on the low voltage side rather than HV pours like before.
    -I'm sure there's a real strategy to these LV traces but I'm not really aware of what that is.
    -Will need to go back and clean up a the pours on the HV side
    --Add fillets
    --proper spacing within same layer
    --More room around fet pins to not bottleneck current
    [120VDC Treadmill Motor Controller.kicad_pcb, 120VDC Treadmill Motor Controller.kicad_sch, Cap_Discharge.kicad_sch, Feeback.kicad_sch, HBridge.kicad_sch, PiPico.kicad_sch, Power.kicad_sch]
2026-03-24 Finished connecting all traces (except for the cap discharge fet which has a pad issue,
    -Starting to rip through DRC
    -Need to clean up most board fills and make sure things look relatively nice
    [120VDC Treadmill Motor Controller.kicad_pcb]
2026-03-26 Fixed some smd pad issues with one of the smaller mosfets.
    -Need to switch back to low on resistance 250v fets to allow for a smaller heatsink
    [120VDC Treadmill Motor Controller.kicad_pcb, HBridge.kicad_sch]
2026-03-30 Need to check fet, caps, connector footprints (and cap discharge) on power subcircuit. Currently working through checking all footprints to hopefully save a major headache if there is a mistake
    [120VDC Treadmill Motor Controller.kicad_pcb, 120VDC Treadmill Motor Controller.kicad_sch, Cap_Discharge.kicad_sch, Feeback.kicad_sch, HBridge.kicad_sch, PiPico.kicad_sch, Power.kicad_sch]
2026-03-30 -Finished checking footprints --Might have issue on the feedback page with DHP1-5-S3-M, where the footprint seems to match digikey cad but not the datasheet
    -Need to review and add testpoints where relavent
    [120VDC Treadmill Motor Controller.kicad_pcb, 120VDC Treadmill Motor Controller.kicad_sch, Cap_Discharge.kicad_sch, Feeback.kicad_sch, HBridge.kicad_sch, PiPico.kicad_sch, Power.kicad_sch]
2026-03-31 -Finished going back and adding some valuable test points. -Realized that 2oz inner copper layer thickness costs way too much so looking at getting 1oz instead. --Need to double check that my pour si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
    [120VDC Treadmill Motor Controller.kicad_pcb, Cap_Discharge.kicad_sch, Feeback.kicad_sch, HBridge.kicad_sch, Power.kicad_sch]
2026-04-01 -Realizing we can only afford 1oz copper on all 4 layers, trying to rework some of the traces and board fills accordingly. -Moved the smaller caps feeding the top of the H bridge directly in front of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
    [120VDC Treadmill Motor Controller.kicad_pcb]
2026-04-02 For cost reasons we want all 1oz copper layers. This means --Inner copper for 20C rise at 1oz = 33mm min width of either trace or board fills --Outer copper for 20C rise at 1oz = 12mm min width of ei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
    The conjestion near the fets makes this challenging
    [120VDC Treadmill Motor Controller.kicad_pcb]
2026-04-02 -Started to move the Current sense off to the side on the board due to limited space for these massive traces and what not. This entails quite a few random moves
    [120VDC Treadmill Motor Controller.kicad_pcb]
2026-04-03 -Finished refactoring the 20amp traces to work with a 4 layer 1oz board. -Working on reconnecting some of the smaller components after some of the moves needed to achieve line 1
    [120VDC Treadmill Motor Controller.kicad_pcb]
2026-04-04 -Finished refactoring for larger minimum board fills and trace sizes -Doing some peer reviews then searching for the best available price online
    [120VDC Treadmill Motor Controller.kicad_pcb]
2026-04-04 -Fixed some more of the high current carrying capacity traces and board fills -Reduced the number of vias being used to jump between layers to allow for wider board fills
    [120VDC Treadmill Motor Controller.kicad_pcb]
2026-04-09 -Started up the programming bit with the hv-moto-coto rust crate revolving around a pico 2 -added a no go zone around bolt heads -started generating a bill of materials and going through pricing, nee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
    [120VDC Treadmill Motor Controller.csv, 120VDC Treadmill Motor Controller.kicad_pcb, 120VDC Treadmill Motor Controller.kicad_sch, Cap_Discharge.kicad_sch, Feeback.kicad_sch, HBridge.kicad_sch, PiPico.kicad_sch, Power.kicad_sch]
2026-04-09 Updated the order sheets and split them into a amazon and a digikey list Digikey came out to around 108 and amazon around 60 (not per board because its an entire resistor and capacitor kit smd kit)
    Need to nut up and press purchase on the board now +start working through the pi pico logic
    [120VDC Treadmill Motor Controller.csv, 120VDC Treadmill Motor Controller.kicad_sch, Cap_Discharge.kicad_sch, Feeback.kicad_sch, HBridge.kicad_sch, Order Sheet Amazon.csv, Order Sheet Digikey.csv, PiPico.kicad_sch]
2026-04-10 -No changes to the board made, submited the design for review through pcb way. Currently quoted at 135 for 5 boards
2026-10-07 Going through some of the nrf mcu bus init functions I has and refactoring them to work with the rpi pico, the spi peripherals on the pico use dma so not seeing a interrupt handler to bind to, not su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
    [bus_init.rs, main.rs]
2026-10-08 Realized my template for the rpi pico was based on a non probe rs non embassy driven template which drove me down some weird rabbit holes. Generated the embassy RP2040 folder and just starting to wor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
    [bus_init.rs, main.rs]
2026-10-09 Finally got println! statements working after lots of asking ai questions and eventually finding a repo that had a decent template.
2026-10-09 Removed one of the failed attempts, going to try and get an actual blinking LED in the morning
    [bus_init.rs, main.rs]
2026-10-12 Finished refactoring the i2c and spi shareable bus even though neither of them are needed for the motor controller lol
2026-10-14 Commiting some of the removal of files -- was having issues with it earlier -- THIS MARKS WHEN MAIN BRANCH REPRESENTS WHAT V2 BOARD SHOULD HAVE
2026-10-14 Starting work on the reading of the hall effect speed sensor. basically just watching for the rising edge. Modified the kicad schematic to pull i2c to 3v3 and not 5v rip
2026-10-14 Continuing work on the hall sensor code. Back tracking a bit to make it easier to unit test some of the math being done to extrapolate a useful rpm
2026-10-15 started reading actual speeds off the small dc motor. Running into issues with noise so going to tackle that next
2026-10-15 Attemped to fix the noise in the hall speed sensor by adding a dounce. Changed the units to us to account for super high speeds (~20K rpm) Pushed the rpm data to the channel Started a direction.rs fi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
2026-10-16 Made some adjustments to the directional control to wait for the rpms to slow down before initiating the switch Also worked on setting up the pwm control Every component is communicating through chan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
2026-10-20 refined some of the pwm.rs code and started a safety.rs file. Approaching the part where we need to solder the HV components to do some LV bench testing. Need to start writing out the PID loop so tha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
2026-10-20 started the main motor.rs file which actually looks at the mesa board inputs and applies a pid loop to the pwm output. Also realized that the mesa input needs a voltage devider so going to have to je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
2026-10-21 Almost have a motor.rs file that is driving the pwm based on a pid loop. Updated a bunch of channels to being signals and watches instead and will need to update some of the firmware to reflect that.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
2026-10-22 I've implemented a cruddy pid loop based on the vset from the mesa. Going to solder up the FETS and whatever is needed to bench test this now
2026-10-26 Made a few readme updates after some soldering. Realized I need to program in the precharge and discharge circuit details before being able to plug the motor in. will keep me busy while i wait on the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
2026-10-26 I've added a precharge cap file and am now reading current and voltage. Both the current and voltage sense will need to be calibrated against real values still missing some safety circuit stuff to dr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
2026-10-31 Calibrated the voltage sense and started attempting to fire the motor controller. Currently the pwm signal is activating the gate driver properly but the direction isn't working properly. The mcu is 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
2026-11-02 Modified the pid loop to work with the small dc motor. working through some logic issues to get directional changes to work. Basically the motor goes to 0 rpm really fast so the hall sensor cant real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
2026-11-02 Working through having the current sense override the speedsense output if the current draw is low
2026-11-02 worked on a bit of logic for the speed sense to avoid blocking behavior when the motor isn't spinning
2026-11-03 Realized I was checking current in the wrong direction which was why my direction changes were so odd. Currently theres some kind of delay happening with when the pwm signal gets sent and the pwm phy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
2026-11-03 Starting to fire up the autotune script, mostly spent time figuring out how to save information in flash so that you don't need to run a autotune script everytime you power up the board
2026-11-04 finally figured out direction change bug. Basically didn't know the ticker for the PID could stack on top of each other so I needed to reset it after a direction change so it wouldn't race to catch u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
    Started working on saving and loading the flash for the autotune setup as well
2026-11-04 Made some more progress on the autotune functionality, mainly surrounding the saving and loading of the PidConfig, need to actually test using this and closing in on a .autotune method that will take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
2026-11-05 Made some progress on the autotune fn Changed the pwm to be a watch so that the autotune fn can read what is being sent to the pins Added a fn to cycle through the bottom 25% of the speed range to fi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
2026-11-06 working on the pwm ladder to speed stuff in the autotune functionality. Got the load and save function working as well for autotune which is nice.
2026-11-06 worked on the lookup table functionality and should have something working ish. Need to get the motor task to actually use the lookup table now which may be a core logic thing
2026-11-09 Started working on physically mounting the test motor to the bench to test stalls and to avoid needing to hold the sensor in place. Hunting down some bug or noise when it comes to speed sense, the 'n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
2026-11-10 Need to add some stall sensing ability, got the physical mount running and going to start figuring out some kind of autotune. Need to add some current calibration on startup still as well
2026-11-11 Fixed a timer bug in speedsense
2026-11-11 Working through the lambda aututune firmware side, basically pulsing the motor with different pwms and logging the speed readout at different times and interpolating the time for the rpm at 1 time co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
2026-11-12 Started bench testing the new PI autotuning firmware. I need to go through and check all the units because I can't tell if this is returning logical answers, ex: for 1142->1421 rpm we're getting kp =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
2026-11-12 Realized I was shifting over the rpms and times for autotune twice rather than once so hopefully that fixes my weird autotune data.
    Wrapped up the rest of the autotune implementation similar to the pwm_floor lookup table -- basically the relavent information should get loaded on the flash on on a restart we'll be using a interpolated P and I calculated by the autotune!
2026-11-12 Working through rewriting the speedsense to output an enum that distinguishes between a hall error, a valid rpm and a stall. We want this so we can start writing the safety circuit and controlling th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
2026-11-13 working through pwming the high and low side in sync but my lack of forsight in doing this during the design phase isn't leaving me with many options, will likely need to ignore this commit
2026-11-14 In order to get the leg to pwm an inverse signal on the high and low side to reduce heat buildup at the fets, we had to do some jerry rigging. I labeled the moves in the schematic and you can tell I 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
    Regardless we do have a better thing going now with 100ns of dead time induced by the gate drivers. The next step is going to be seeing if we can measure the current at the midpoint of the pwm signals ... might be difficult with the pico -- starting to regret using this board given many of its short comings
