VinceVol/High_Voltage_DC_Motor_Drive/(notices)

Notices in the files:
Readable_Schema/Local_Components/ESMQ351VSN821MA45S/E-SNAP-IN_D35_L45__VSN_SLEEVE_STRUCTURE.stp:
COPYRIGHT:NIPPON CHEMI-CON CORPORATION <https://www.chemi-con.co.jp/>
